dbornhorst/JacquardMachine-PCB/hardware/Jacquard_Machine_Brain/Jacquard_Machine_Brain.png

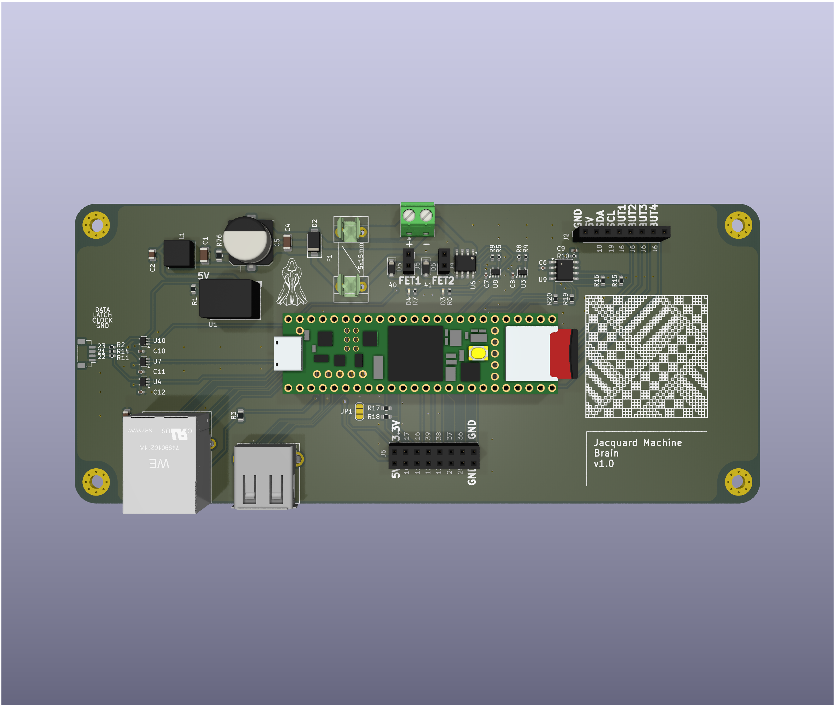
hardware/Jacquard_Machine_Brain/Jacquard_Machine_Brain.png
