dbornhorst/JacquardMachine-PCB/hardware/Jacquard_Machine_Driver/Jacquard_Machine_Driver.png

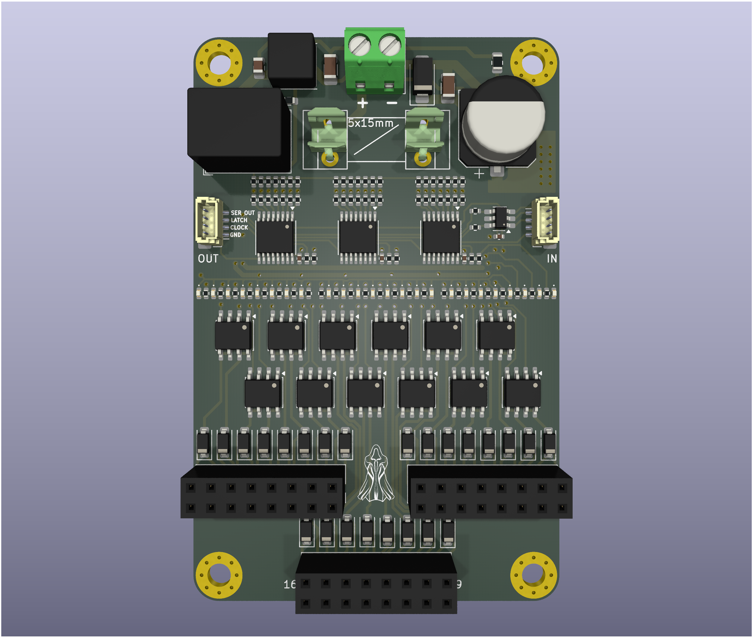
hardware/Jacquard_Machine_Driver/Jacquard_Machine_Driver.png
