dbornhorst/JacquardMachine-PCB/hardware/Jacquard_Machine_Driver/Jacquard_Machine_Driver.step

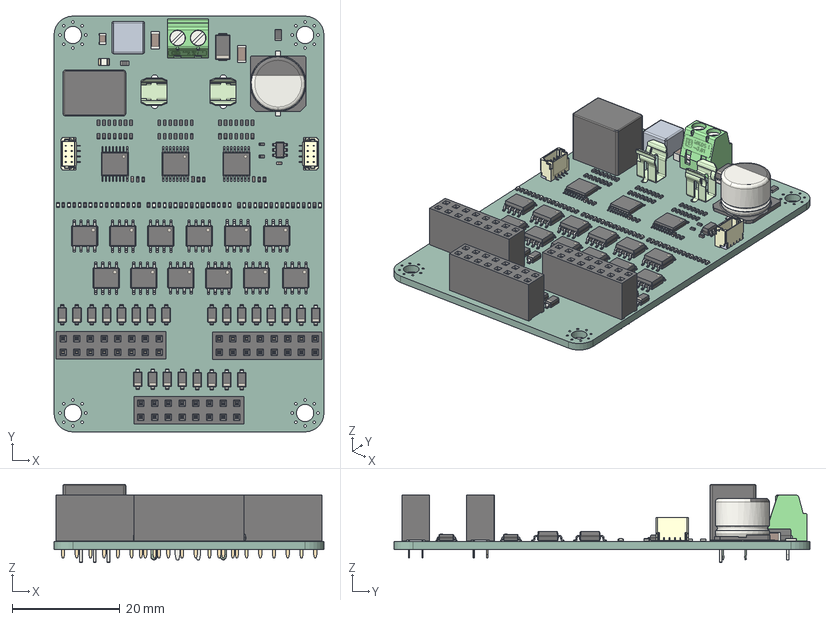
[picture p3: CAD file, 2026-09-17]
hardware/Jacquard_Machine_Driver/Jacquard_Machine_Driver.step
50.0 x 77.0 x 14.5 mm
R_0402_1005Metric x 74
LED_0805_2012Metric
LED_0402_1005Metric x 24
SOT-23-6
JST-SH_4POS_VERT_BM04B-SRSS-TB_LF x 2
SOIC-8_3.9x4.9mm_P1.27mm x 12
D_SOD-123 x 24
PinSocket_2x08_P2.54mm_Vertical x 3
Jacquard_Machine_Driver 1.19.1
C_0402_1005Metric x 4
Converter_DCDC_RECOM_R-78E-0.5_THT
TSSOP-16_4.4x5mm_P0.65mm x 3
C_0805_2012Metric
C_1206_3216Metric x 2
2AG_Fuse_Clip x 2
R_0603_1608Metric
CP_Elec_10x7.9
R_0805_2012Metric
D_SMA
Jacquard_Machine_Driver_PCB
