dbornhorst/JacquardMachine-PCB/hardware/Jacquard_Machine_Brain/documentation/Jacquard_Machine_Brain-v1.0-FAB.pdf

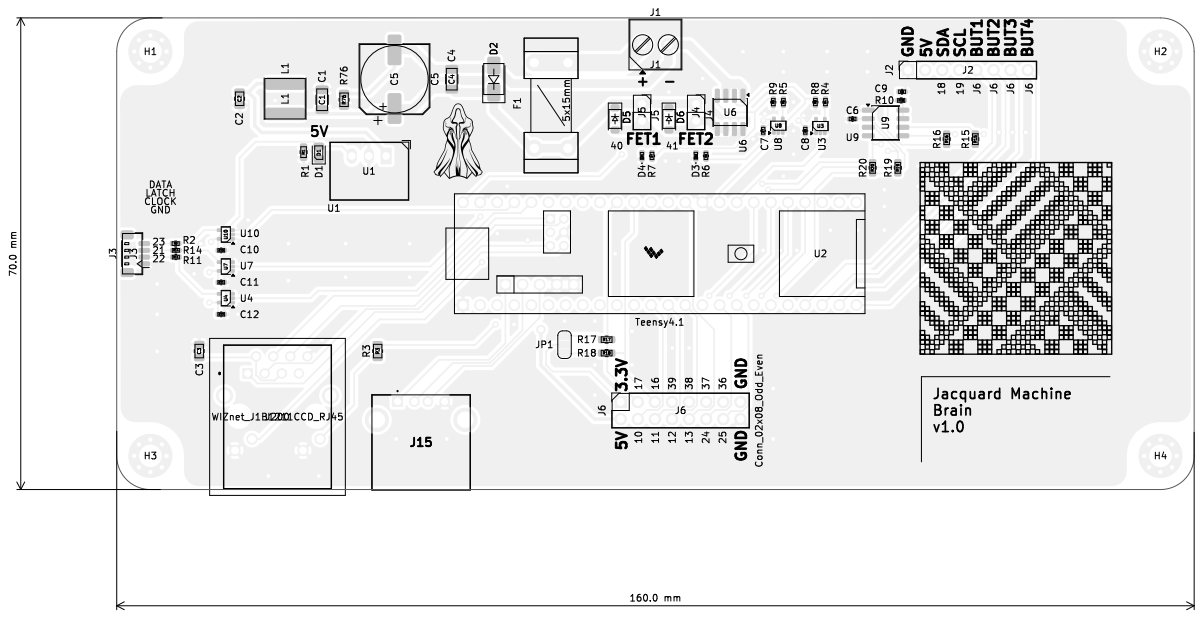
[picture p4: page 1]

File: Jacquard_Machine_Brain.kicad_pcb Sheet: Black And White TOP Daniel Bornhorst dbornhorst@gmail.com

Id: /1 Title: Jacquard Machine Brain

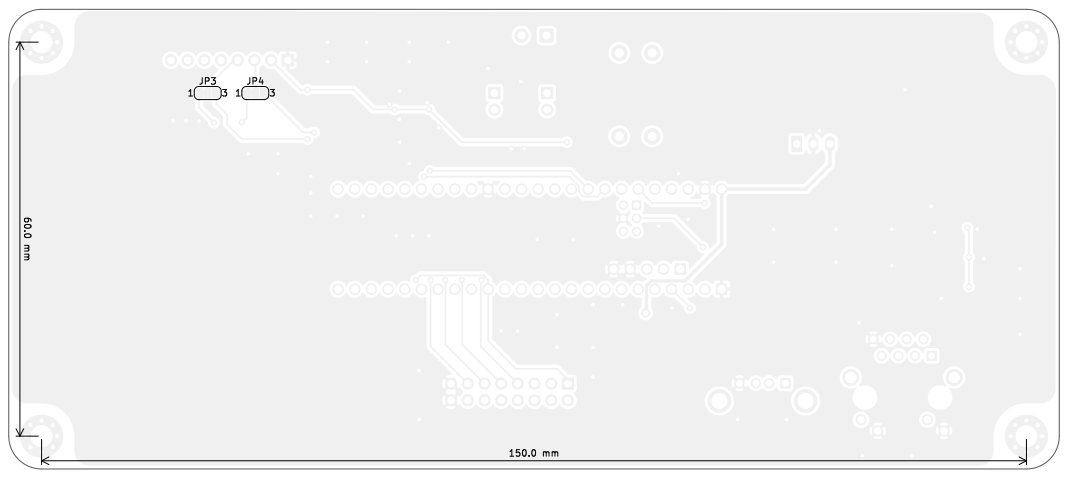
[picture p5: page 2]
D Date: 2026-09-15 KiCad; E.D.A. 9.0.6 Size: A4; Rev: v1.0; File: Jacquard_Machine_Brain.kicad_pcb Sheet: Black; And; White; BOT Daniel; Bornhorst dbornhorst@gmail.com; Board2Pdf:; Black; BOT -; Page 2/2

Id: /1 Title: Jacquard Machine Brain
