dbornhorst/JacquardMachine-PCB/hardware/Jacquard_Machine_Driver/documentation/Jacquard_Machine_Driver-v1.0-FAB.pdf

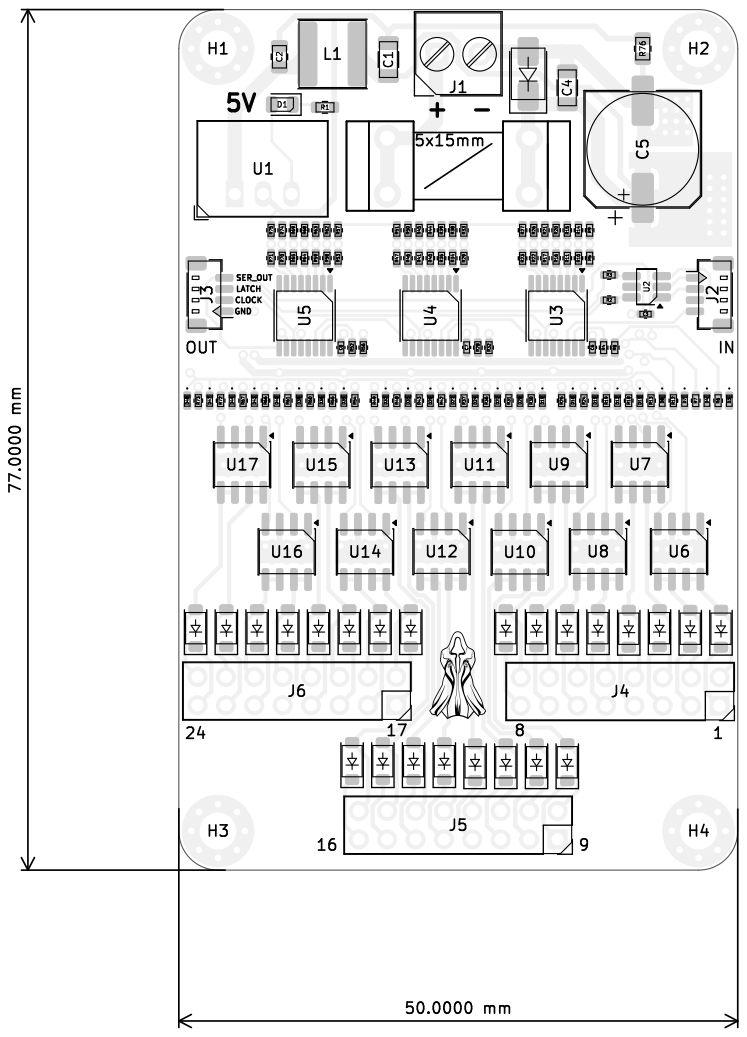
[picture p6: page 1]

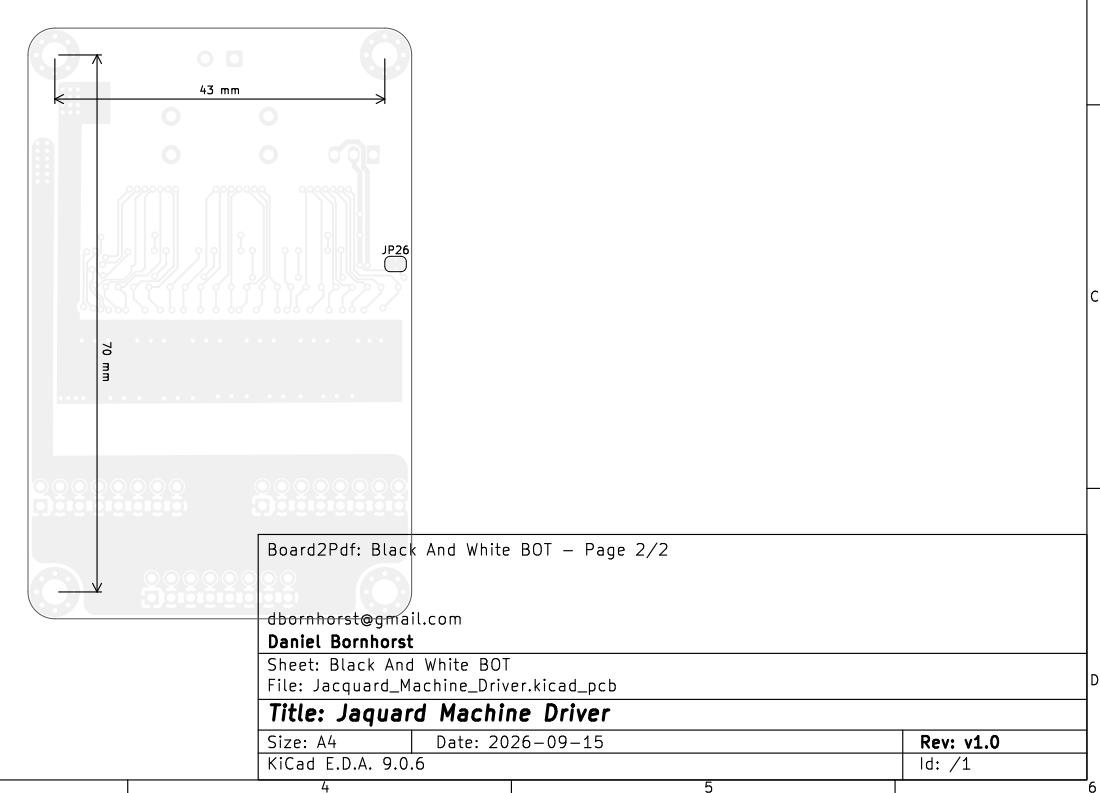
[picture p7: page 2]
D Date: 2026-09-15 KiCad; E.D.A. 9.0.6 Size: A4; Rev: v1.0; Id: /1 Title: Jaquard Machine Driver File: Jacquard_Machine_Driver.kicad_pcb Sheet: Black; And; White; BOT Daniel; Bornhorst dbornhorst@gmail.com; Board2Pdf:; Black; BOT -; Page 2/2
