dbornhorst/JacquardMachine-PCB/hardware/Jacquard_Machine_Brain/documentation/Jacquard_Machine_Brain-v1.0-SCHEM.pdf

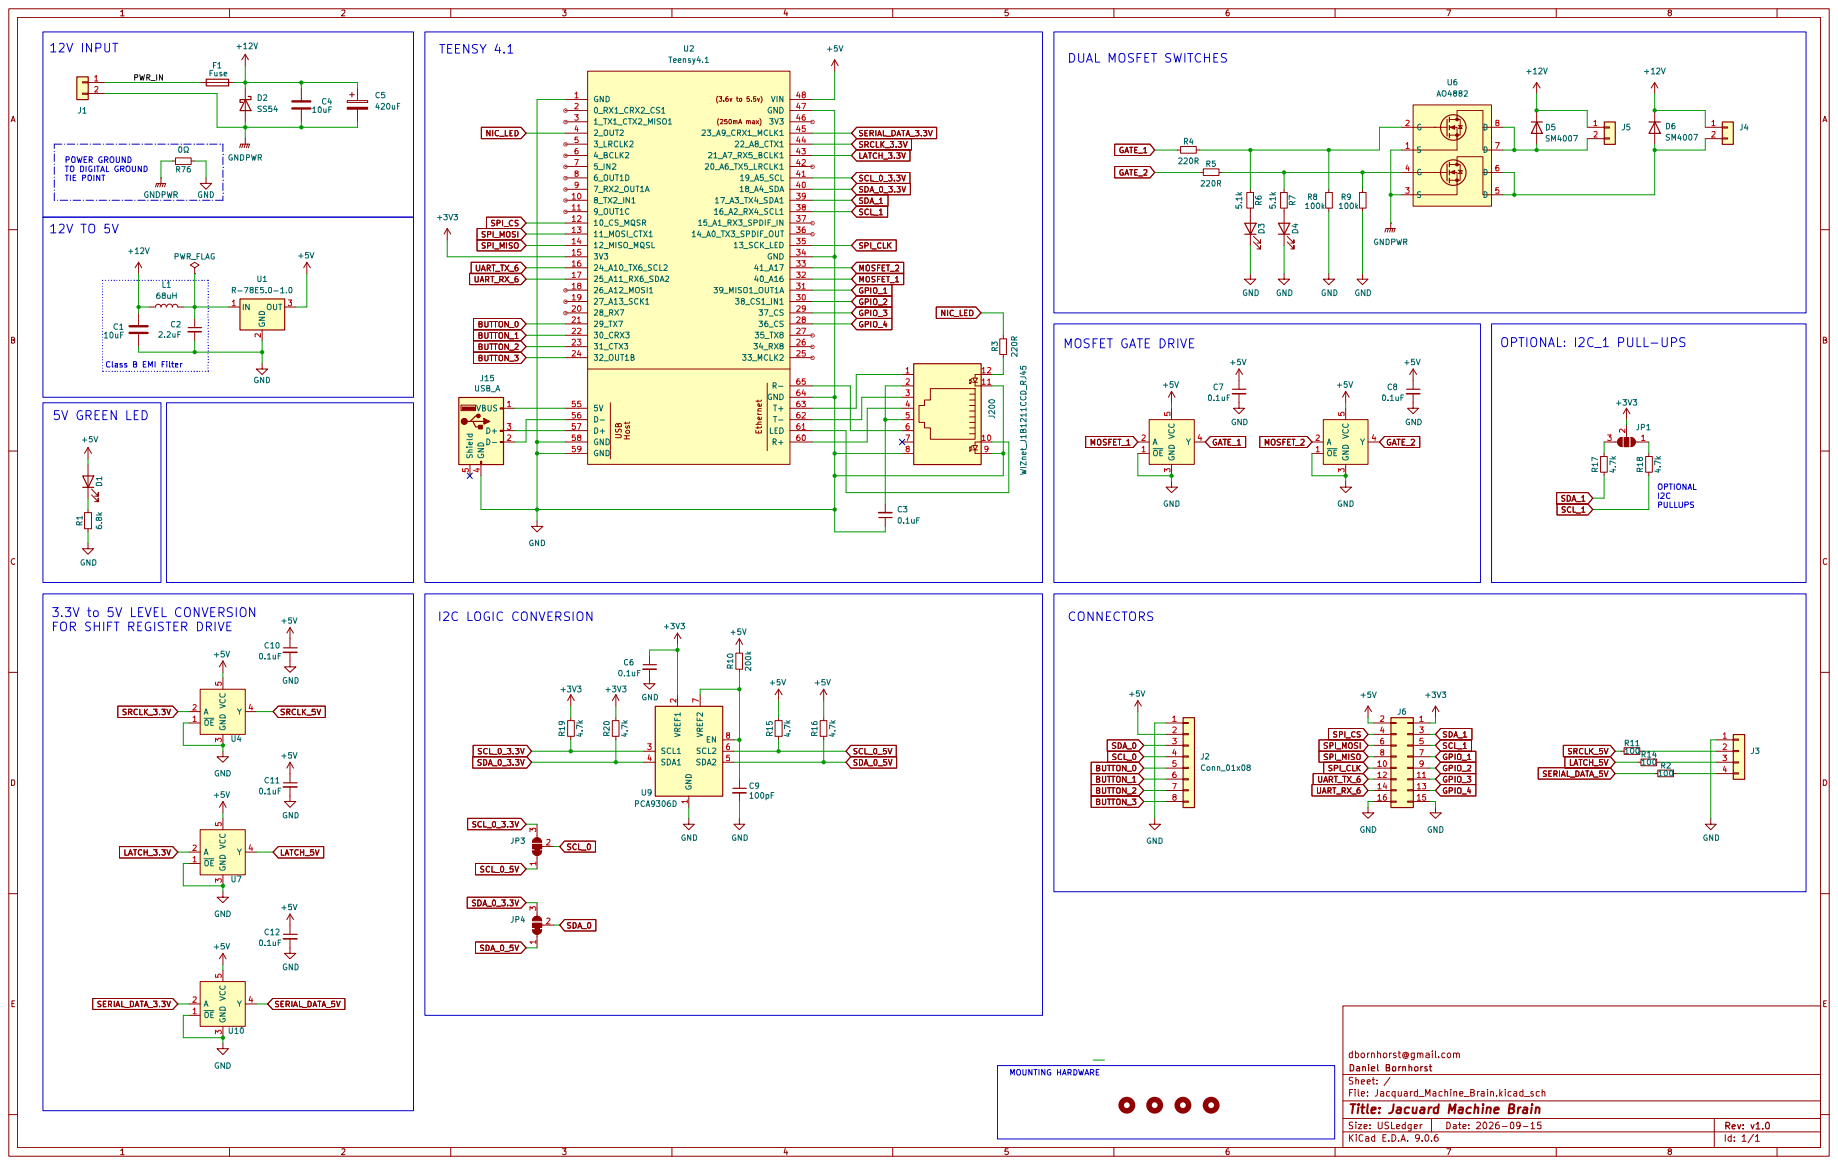
[picture p8: page 1]
