dbornhorst/JacquardMachine-PCB/hardware/Jacquard_Machine_Driver/documentation/Jacquard_Machine_Driver-v1.0-SCHEM.pdf

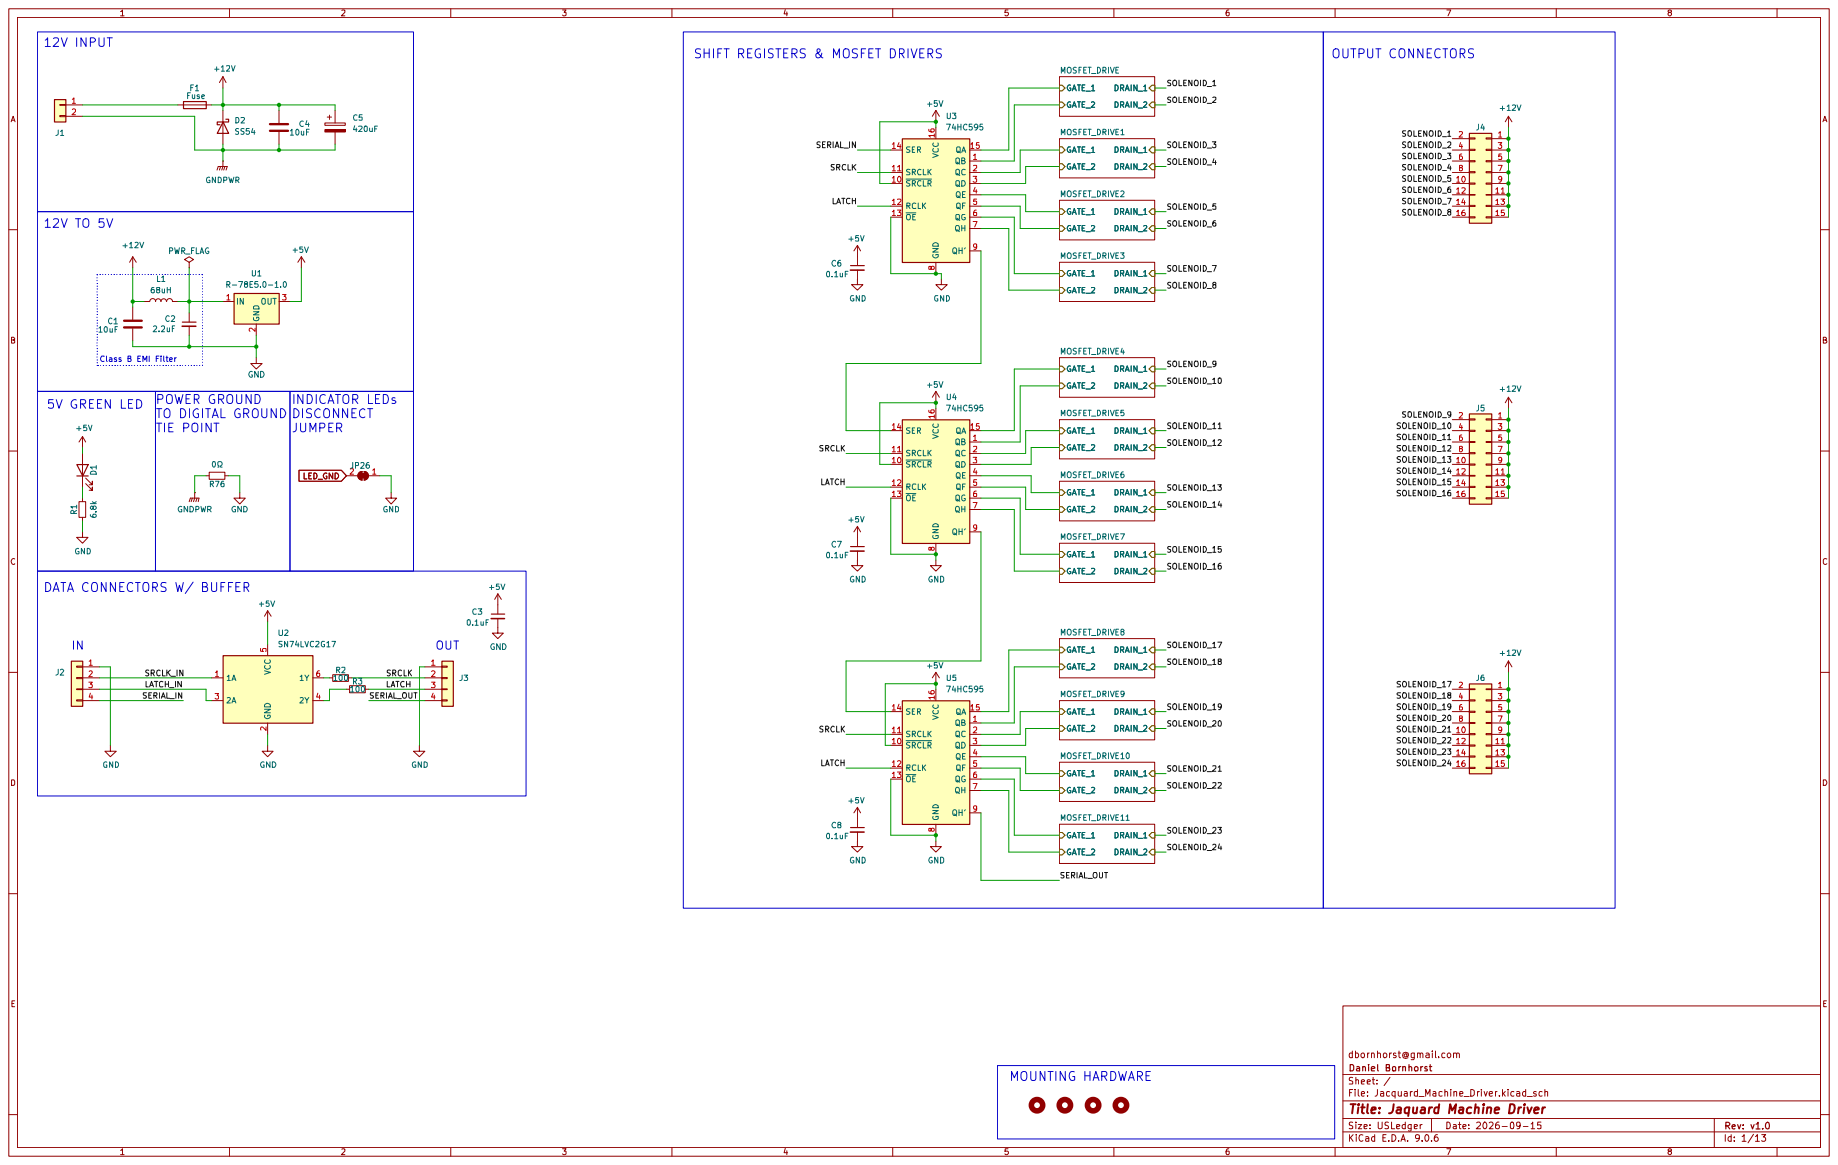
[picture p9: page 1]

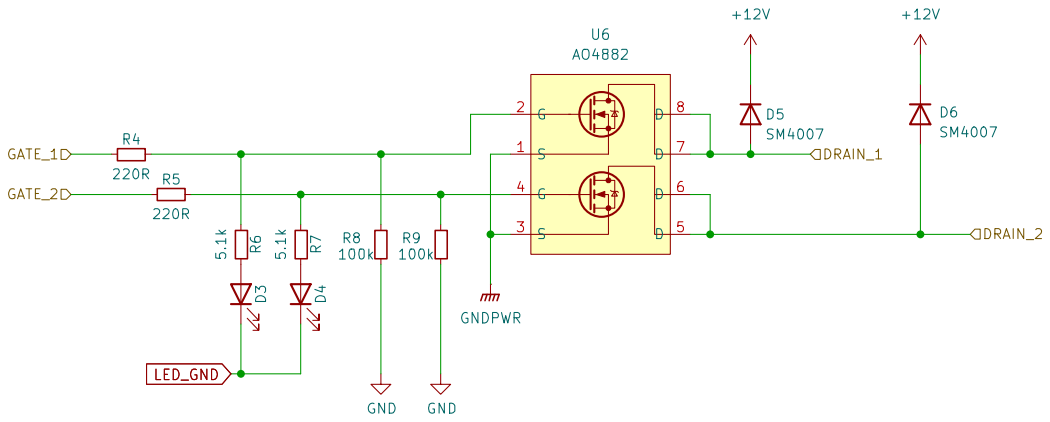
[picture p10: page 2]
