dbornhorst/JacquardMachine-PCB/hardware/Jacquard_Machine_Brain/Jacquard_Machine_Brain.kicad_pcb

## KiCad design hardware/Jacquard_Machine_Brain/Jacquard_Machine_Brain.kicad_pcb (2026-09-17)

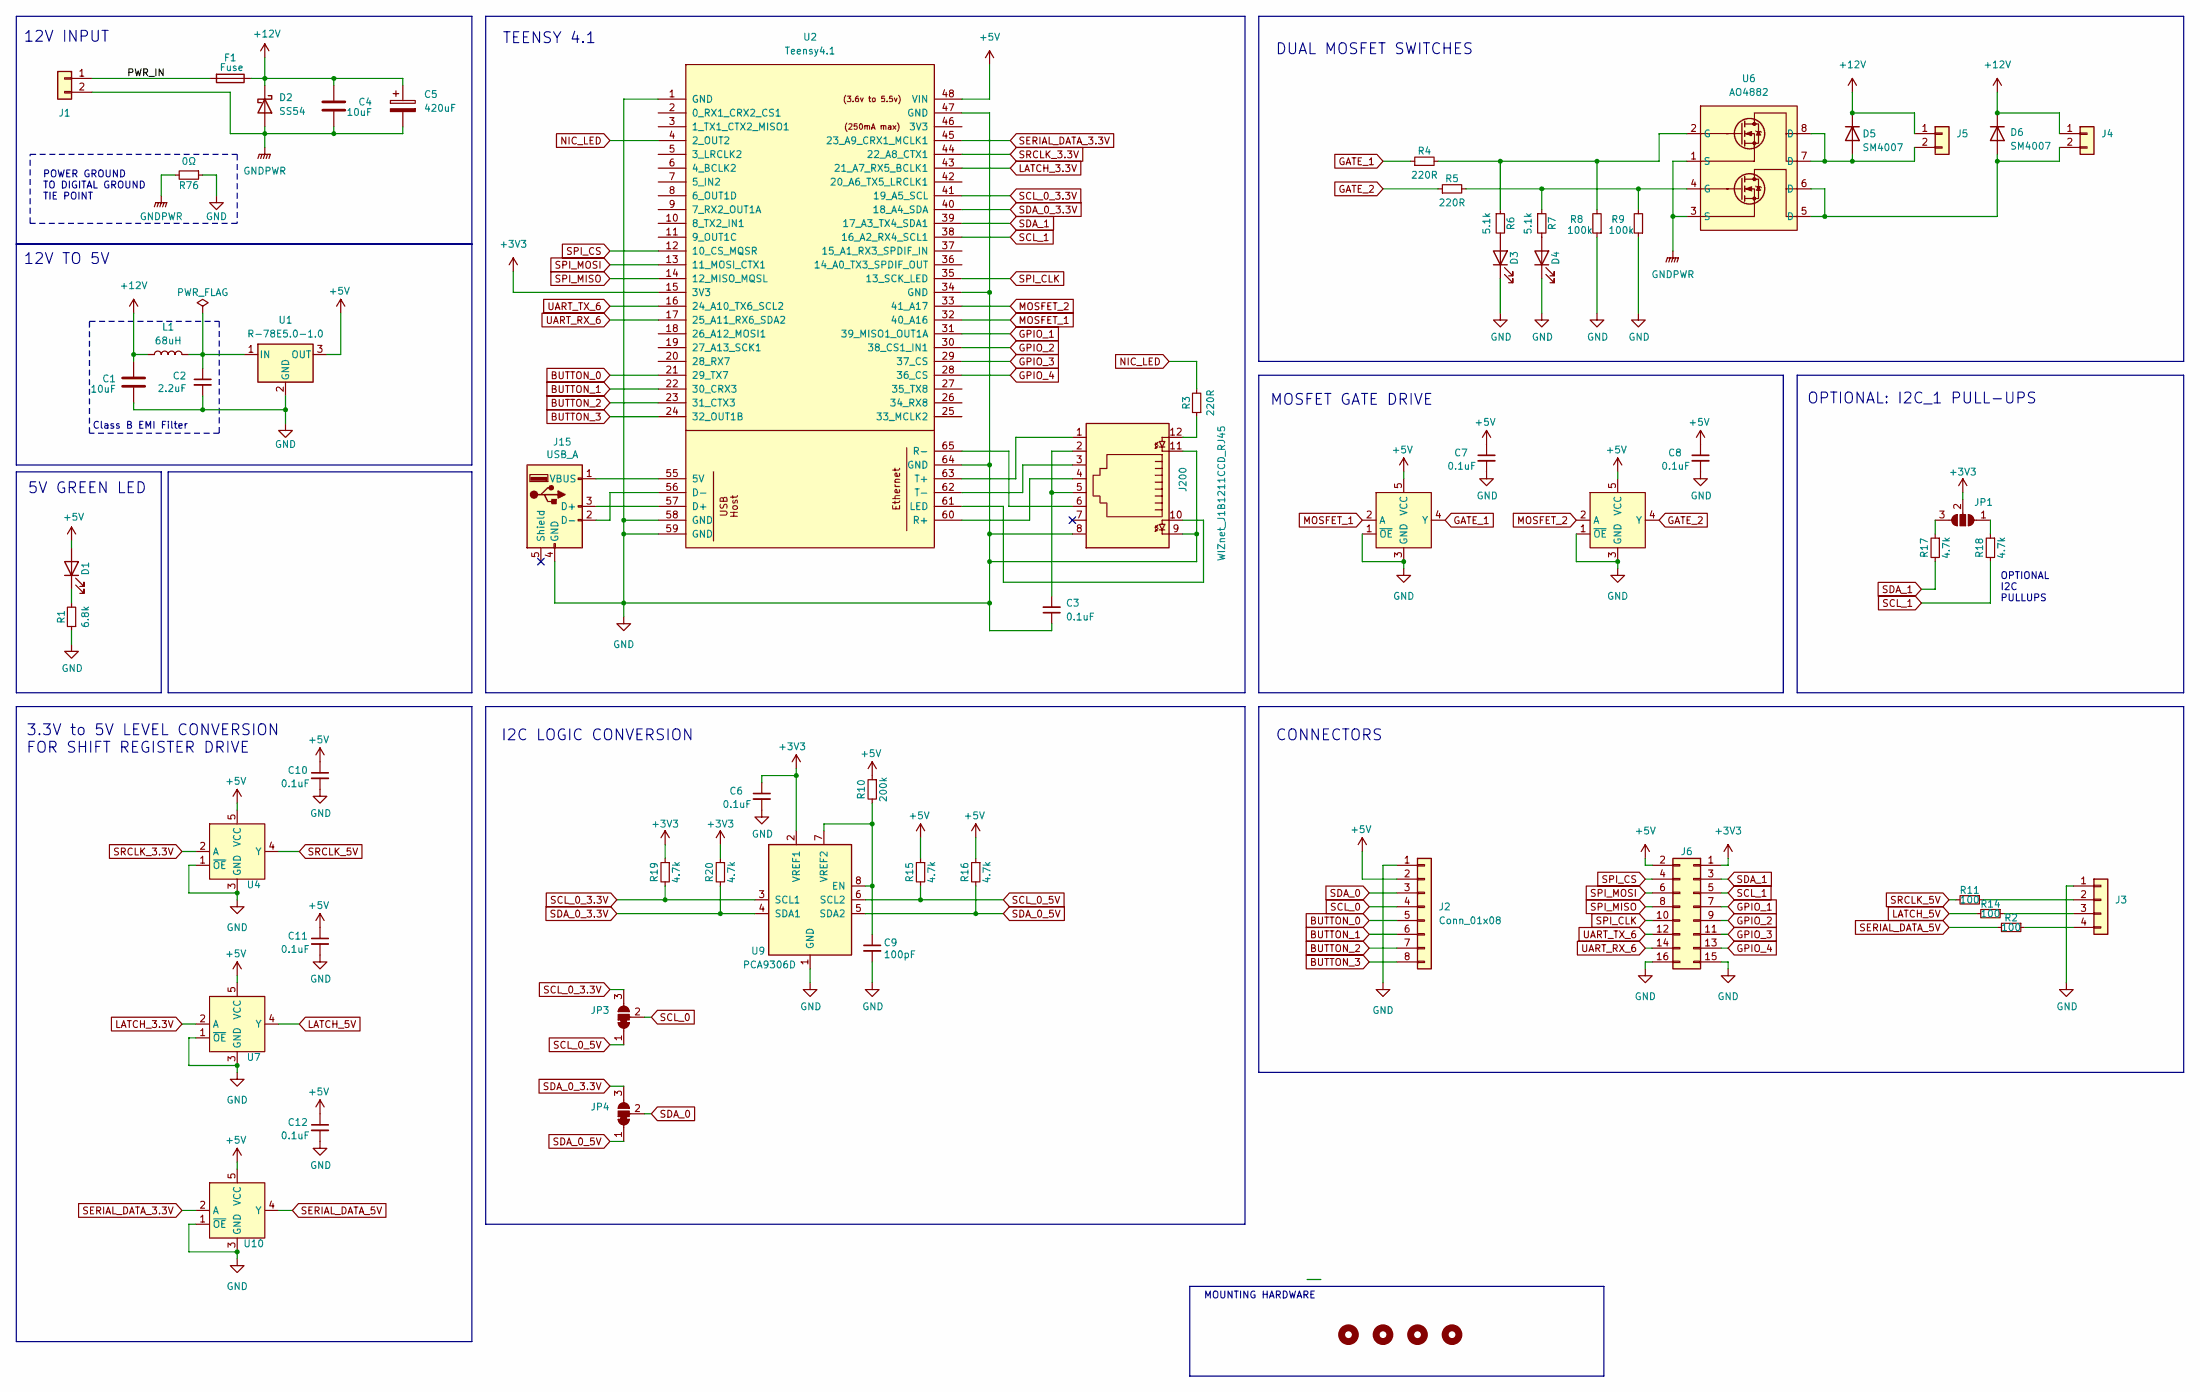
[picture p11: schematic Jacquard_Machine_Brain.kicad_sch, Jacuard Machine Brain]

Parts:
C1, C4: 10uF; C_1206_3216Metric; LCSC C13585
C2: 2.2uF; C_0805_2012Metric; LCSC C377773
C3: 0.1uF; C_0805_2012Metric; LCSC C49678
C5: 420uF; CP_Elec_10x7.9; LCSC C3350
C6, C7, C8, C10, C11, C12: 0.1uF; C_0402_1005Metric; LCSC C1525
C9: 100pF; C_0402_1005Metric; LCSC C1546
D1: GREEN LED; LED_0805_2012Metric; LCSC C2297
D2: SS54; D_SMA; LCSC C22452
D3, D4: RED LED; LED_0402_1005Metric; LCSC C397045
D5, D6: SM4007; D_SOD-123; LCSC C64898
F1: Fuse; Fuseholder_2AG_5x15mm_Littelfuse_01110501Z; LCSC C151075
H1, H2, H3, H4: MountingHole; MountingHole_3.2mm_M3_Pad_Via
J1: Terminal Block; TerminalBlock_Phoenix_MKDS-1-2-3.81_1x02_P3.81mm_Horizontal; LCSC C89123
J2: Conn_01x08; PinSocket_1x08_P2.54mm_Vertical; LCSC C42431840
J3: JST-SH 01x04; JST_SH_BM04B-SRSS-TB_1x04-1MP_P1.00mm_Vertical; LCSC C160390
J4, J5: Conn_01x02; PinSocket_1x02_P2.54mm_Vertical; LCSC C7499322
J6: Conn_02x08_Odd_Even; PinSocket_2x08_P2.54mm_Vertical; LCSC C30734
J15: USB_A; SAMTEC_USB-A-S-S-W-TH; LCSC C5815125
J200: WIZnet_J1B1211CCD_RJ45; Digikey P/N 1278-1052-ND
JP1: SolderJumper_3_Bridged123; SolderJumper-3_P1.3mm_Open_RoundedPad1.0x1.5mm
JP3, JP4: SolderJumper_3_Bridged12; SolderJumper-3_P1.3mm_Bridged12_RoundedPad1.0x1.5mm_NumberL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
L1: 68uH; L_Sunlord_SWPA6045S; LCSC C53663
R1: 6.8k; R_0603_1608Metric; LCSC C23212
R2, R11, R14: 100; R_0402_1005Metric; LCSC C25076
R3: 220R; R_0805_2012Metric; Digikey P/N 311-220CRCT-ND
R4, R5: 220R; R_0402_1005Metric; LCSC C25091
R6, R7: 5.1k; R_0402_1005Metric; LCSC C25905
R8, R9: 100k; R_0402_1005Metric; LCSC C25741
R10: 200k; R_0402_1005Metric; LCSC C25764
R15, R16, R17, R18, R19, R20: 4.7k; R_0603_1608Metric; LCSC C23162
R76: 0Ω; R_0805_2012Metric; LCSC C17477
U1: R-78E5.0-1.0; Converter_DCDC_RECOM_R-78E-0.5_THT; LCSC C22371890
U2: Teensy4.1; Teensy41_ethernet_usb; LCSC C41376163
U3, U4, U7, U8, U10: 74AHCT1G125; SOT-353_SC-70-5; LCSC C151417
U6: AO4882; SOIC-8_3.9x4.9mm_P1.27mm; LCSC C477943
U9: PCA9306D; SO-8_3.9x4.9mm_P1.27mm; LCSC C2677369

Connections:
+3V3: C6.1, J6.1, JP1.2 (C), R19.1, R20.1, U2.15 (3V3), U9.2 (VREF1)
+5V: C7.1, C8.1, C10.1, C11.1, C12.1, D1.2 (A), J2.2, J6.2, R10.1, R15.1, R16.1, U1.3 (OUT), U2.48 (VIN), U3.5 (VCC), U4.5 (VCC), U7.5 (VCC), U8.5 (VCC), U10.5 (VCC)
+12V: C1.1, C4.1, C5.1, D2.1 (K), D5.1 (K), D6.1 (K), F1.1, J4.1, J5.1, L1.1
/PWR_IN: F1.2, J1.1
BUTTON_0: J2.5, U2.21 (29_TX7)
BUTTON_1: J2.6, U2.22 (30_CRX3)
BUTTON_2: J2.7, U2.23 (31_CTX3)
BUTTON_3: J2.8, U2.24 (32_OUT1B)
GATE_1: R4.1, U3.4 (Y)
GATE_2: R5.1, U8.4 (Y)
GND: C1.2, C2.2, C3.1, C6.2, C7.2, C8.2, C9.2, C10.2, C11.2, C12.2, D3.1 (K), D4.1 (K), J2.1, J3.1, J6.15, J6.16, J15.4 (GND), J200.8, J200.9, J200.11, R1.1, R8.1, R9.1, R76.1, U1.2 (GND), U2.1 (GND), U2.34 (GND), U2.47 (GND), U2.58 (GND), U2.59 (GND), U2.64 (GND), U3.1 (~OE), U3.3 (GND), U4.1 (~OE), U4.3 (GND), U7.1 (~OE), U7.3 (GND), U8.1 (~OE), U8.3 (GND), U9.1 (GND), U10.1 (~OE), U10.3 (GND)
GNDPWR: C4.2, C5.2, D2.2 (A), J1.2, R76.2, U6.1 (S), U6.3 (S)
GPIO_1: J6.7, U2.31 (39_MISO1_OUT1A)
GPIO_2: J6.9, U2.30 (38_CS1_IN1)
GPIO_3: J6.11, U2.29 (37_CS)
GPIO_4: J6.13, U2.28 (36_CS)
LATCH_3.3V: U2.43 (21_A7_RX5_BCLK1), U7.2 (A)
LATCH_5V: R14.2, U7.4 (Y)
MOSFET_1: U2.32 (40_A16), U3.2 (A)
MOSFET_2: U2.33 (41_A17), U8.2 (A)
NIC_LED: R3.2, U2.4 (2_OUT2)
unnamed: C3.2, J200.2, J200.5
unnamed: D1.1 (K), R1.2
unnamed: D3.2 (A), R6.2
unnamed: D4.2 (A), R7.2
unnamed: D5.2 (A), J5.2, U6.7 (D), U6.8 (D)
unnamed: D6.2 (A), J4.2, U6.5 (D), U6.6 (D)
unnamed: J3.2, R11.1
unnamed: J3.3, R14.1
unnamed: J3.4, R2.1
unnamed: J15.3 (D+), U2.57 (D+)
unnamed: J15.2 (D-), U2.56 (D-)
unnamed: J15.1 (VBUS), U2.55 (5V)
unnamed: J200.12, R3.1
unnamed: JP1.1 (A), R18.1
unnamed: JP1.3 (B), R17.1
unnamed: R4.2, R6.1, R8.2, U6.2 (G)
unnamed: R5.2, R7.1, R9.2, U6.4 (G)
unnamed: C2.1, L1.2, U1.1 (IN)
unnamed: J200.10, U2.61 (LED)
unnamed: J200.4, U2.60 (R+)
unnamed: J200.6, U2.65 (R-)
unnamed: J200.1, U2.63 (T+)
unnamed: J200.3, U2.62 (T-)
unnamed: C9.1, R10.2, U9.7 (VREF2), U9.8 (EN)
SCL_0: J2.4, JP3.2 (C)
SCL_0_3.3V: JP3.3 (B), R19.2, U2.41 (19_A5_SCL), U9.3 (SCL1)
SCL_0_5V: JP3.1 (A), R15.2, U9.6 (SCL2)
SCL_1: J6.5, R18.2, U2.38 (16_A2_RX4_SCL1)
SDA_0: J2.3, JP4.2 (C)
SDA_0_3.3V: JP4.3 (B), R20.2, U2.40 (18_A4_SDA), U9.4 (SDA1)
SDA_0_5V: JP4.1 (A), R16.2, U9.5 (SDA2)
SDA_1: J6.3, R17.2, U2.39 (17_A3_TX4_SDA1)
SERIAL_DATA_3.3V: U2.45 (23_A9_CRX1_MCLK1), U10.2 (A)
SERIAL_DATA_5V: R2.2, U10.4 (Y)
SPI_CLK: J6.10, U2.35 (13_SCK_LED)
SPI_CS: J6.4, U2.12 (10_CS_MQSR)
SPI_MISO: J6.8, U2.14 (12_MISO_MQSL)
SPI_MOSI: J6.6, U2.13 (11_MOSI_CTX1)
SRCLK_3.3V: U2.44 (22_A8_CTX1), U4.2 (A)
SRCLK_5V: R11.2, U4.4 (Y)
UART_RX_6: J6.14, U2.17 (25_A11_RX6_SDA2)
UART_TX_6: J6.12, U2.16 (24_A10_TX6_SCL2)

Notes on the sheet:
OPTIONAL: I2C_1 PULL-UPS
5V GREEN LED
3.3V to 5V LEVEL CONVERSION FOR SHIFT REGISTER DRIVE
I2C LOGIC CONVERSION
TEENSY 4.1
MOSFET GATE DRIVE
DUAL MOSFET SWITCHES
MOUNTING HARDWARE
OPTIONAL I2C PULLUPS
12V INPUT
12V TO 5V
Class B EMI Filter
POWER GROUND TO DIGITAL GROUND TIE POINT
CONNECTORS

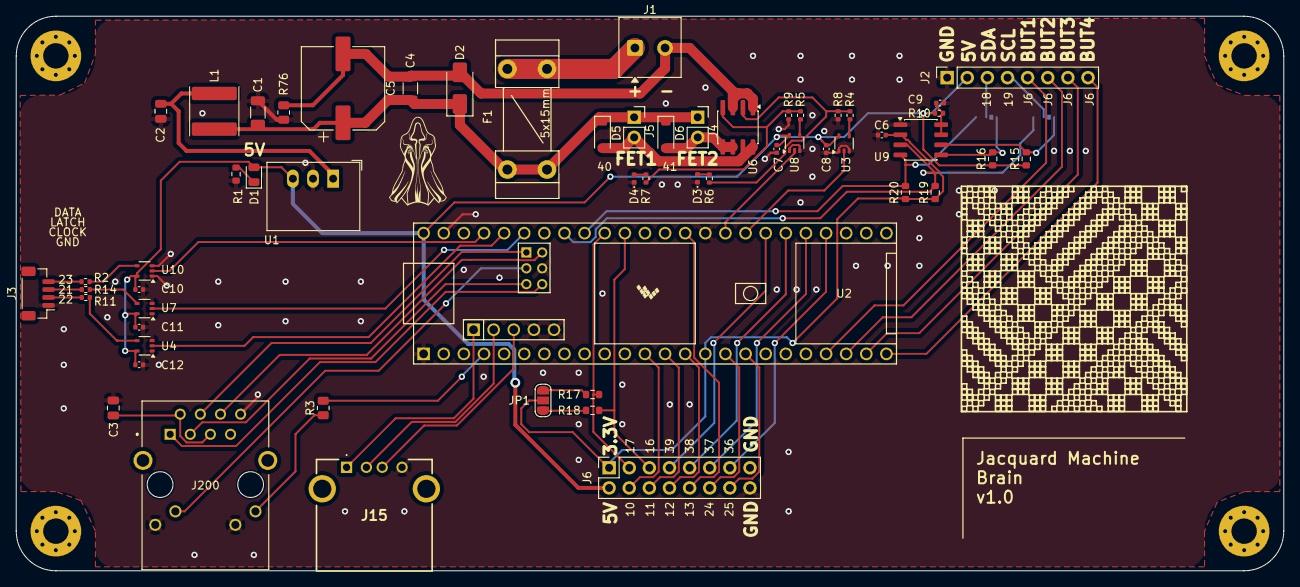
[picture p12: board Jacquard_Machine_Brain.kicad_pcb from above]

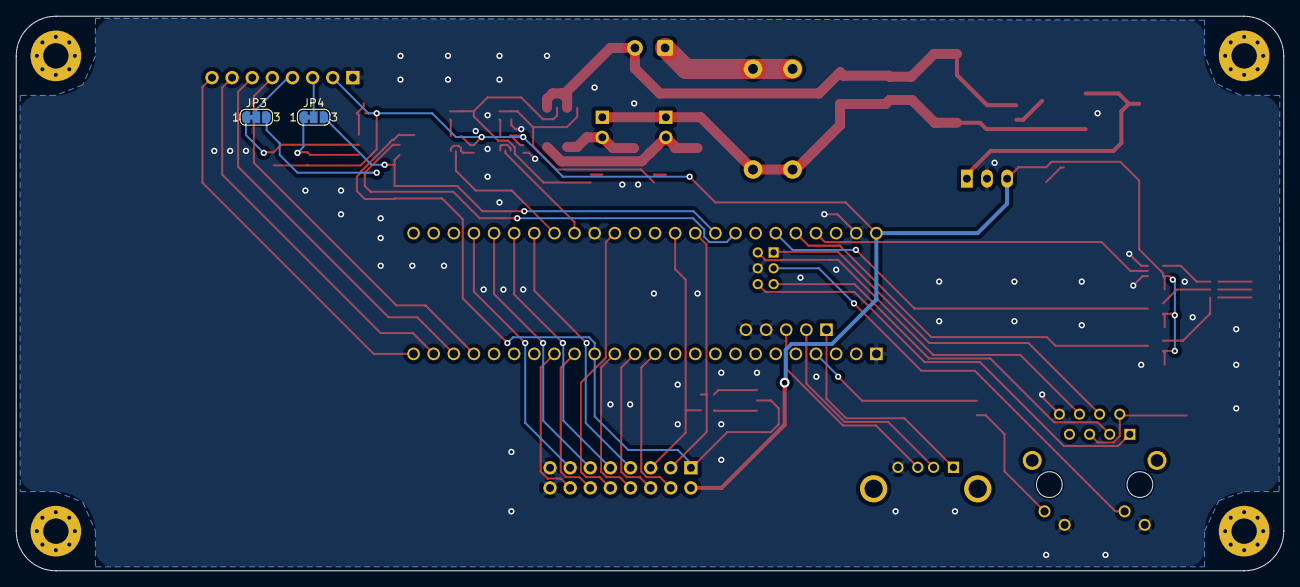
[picture p13: board Jacquard_Machine_Brain.kicad_pcb from below]

Board: 2 copper layers, 160.0 x 70.0 mm, 63 parts (2 on the bottom side), 63 nets.
