dbornhorst/JacquardMachine-PCB/hardware/Jacquard_Machine_Driver/Jacquard_Machine_Driver.kicad_pcb

## KiCad design hardware/Jacquard_Machine_Driver/Jacquard_Machine_Driver.kicad_pcb (2026-09-17)

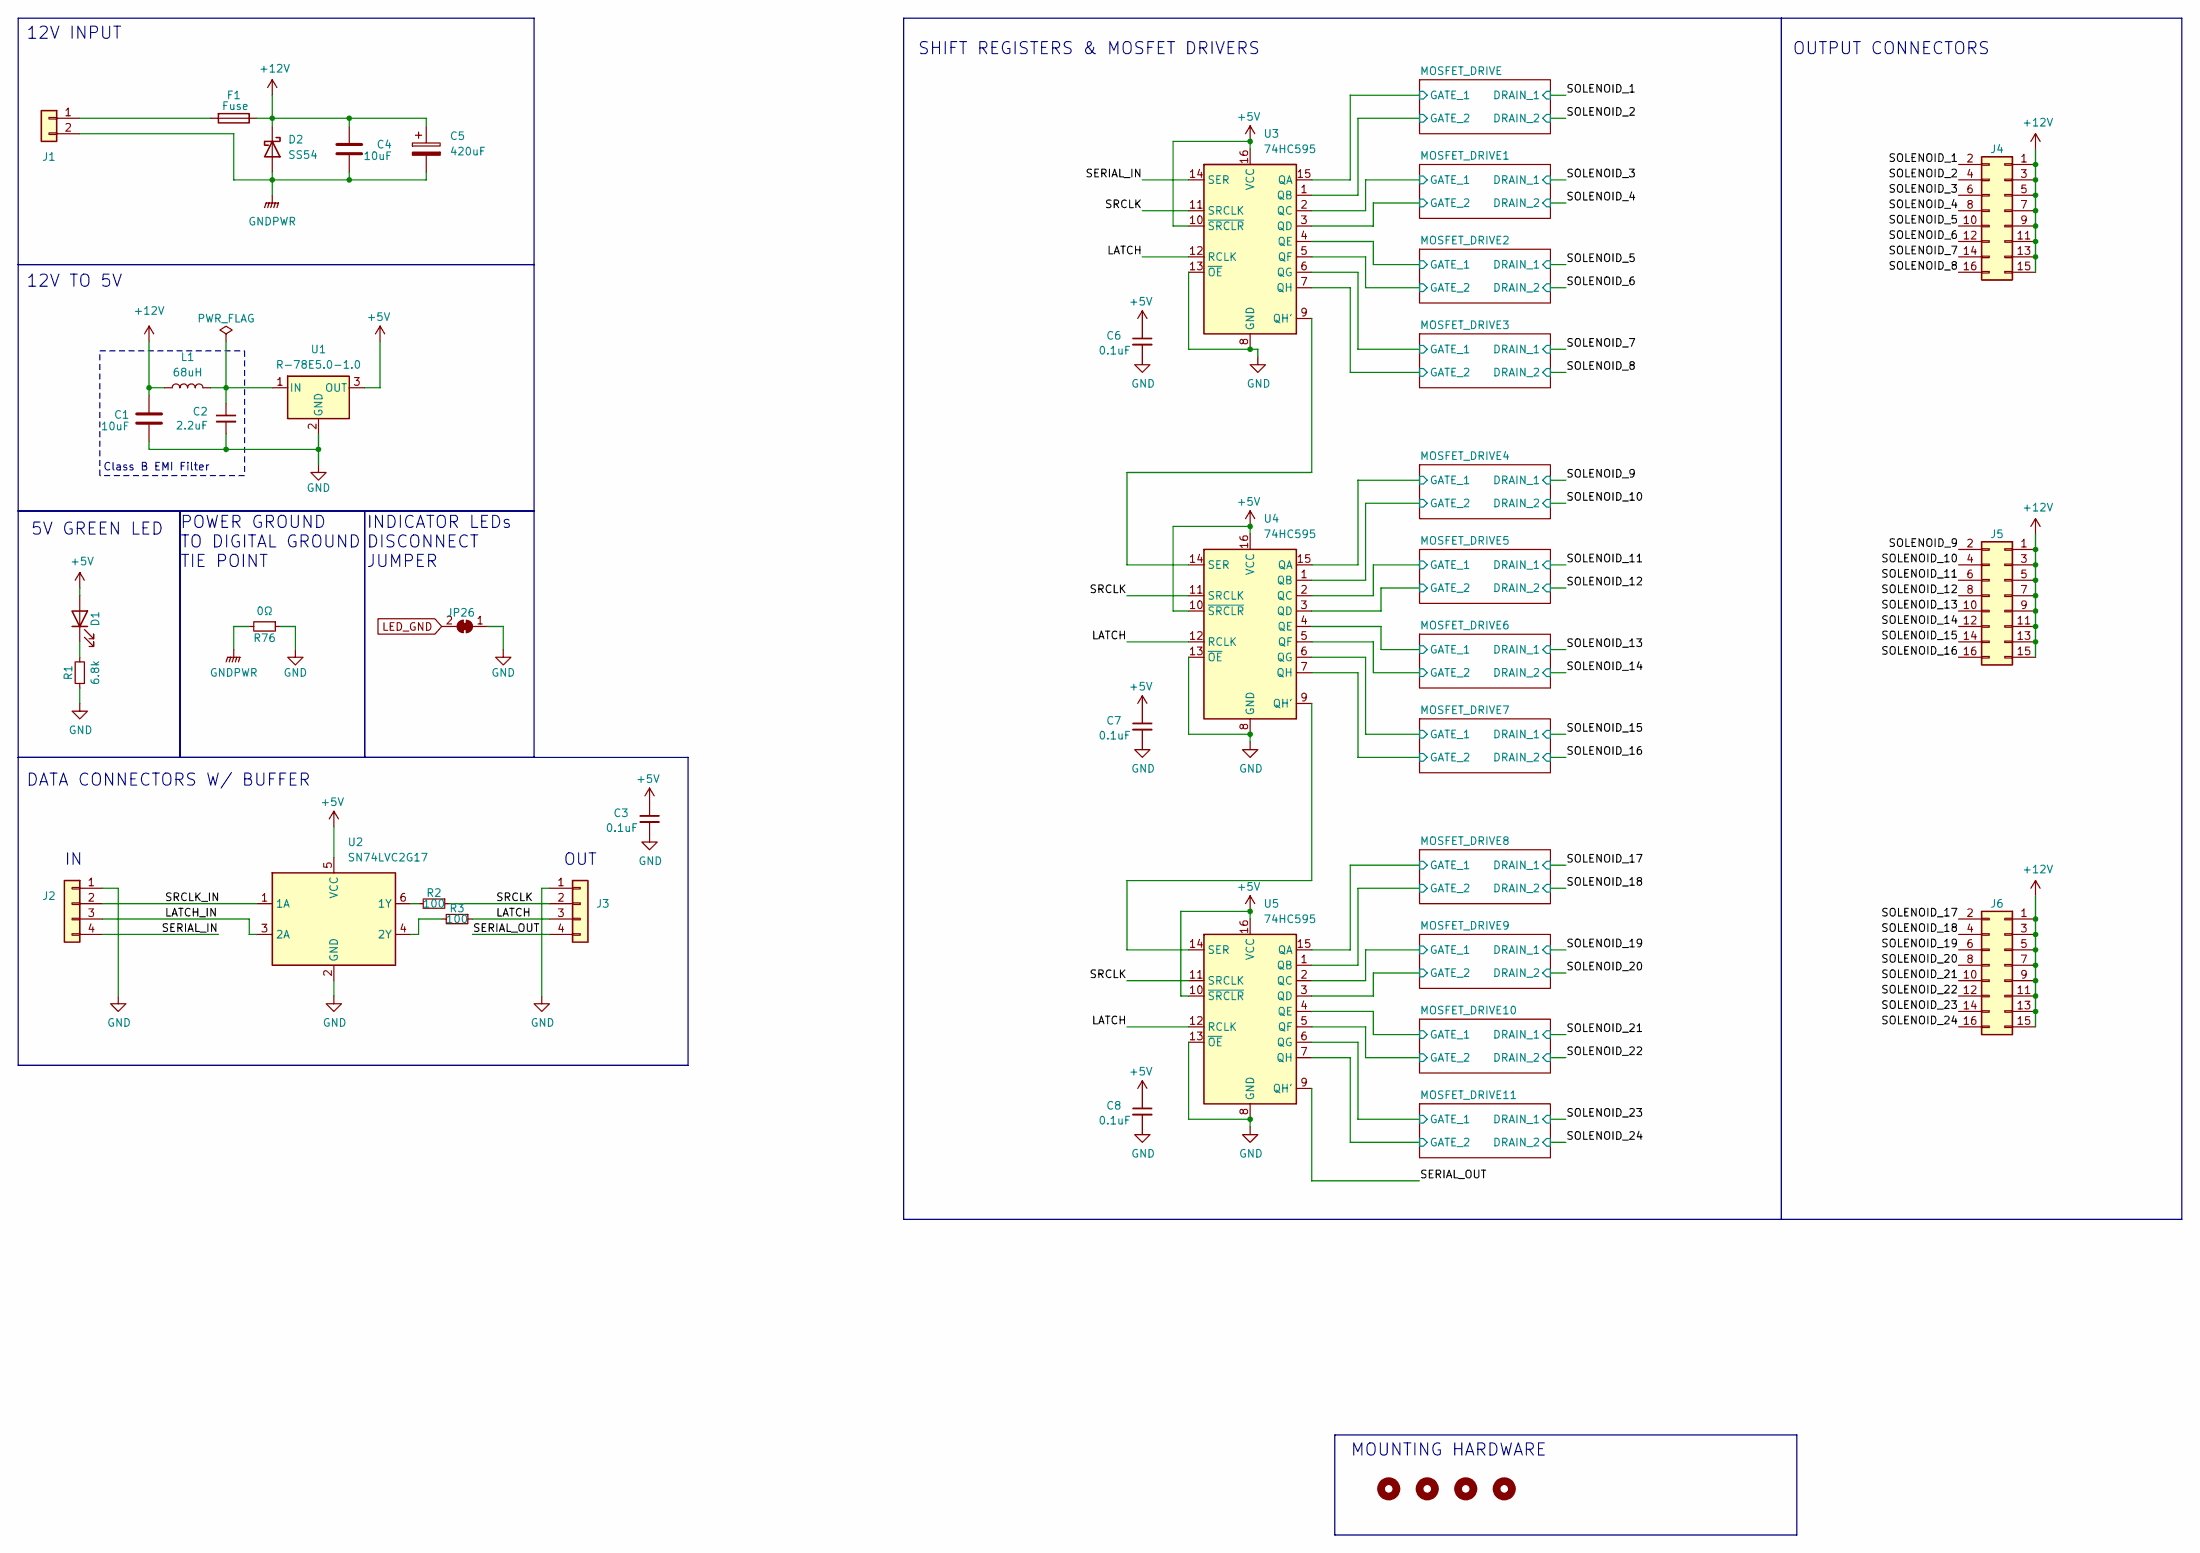
[picture p14: schematic Jacquard_Machine_Driver.kicad_sch, Jaquard Machine Driver]

Parts:
C1, C4: 10uF; C_1206_3216Metric; LCSC C13585
C2: 2.2uF; C_0805_2012Metric; LCSC C377773
C3, C6, C7, C8: 0.1uF; C_0402_1005Metric; LCSC C1525
C5: 420uF; CP_Elec_10x7.9; LCSC C3350
D1: GREEN LED; LED_0805_2012Metric; LCSC C2297
D2: SS54; D_SMA; LCSC C22452
F1: Fuse; Fuseholder_2AG_5x15mm_Littelfuse_01110501Z; LCSC C151075
H1, H2, H3, H4: MountingHole; MountingHole_3.2mm_M3_Pad_Via
J1: Terminal Block; TerminalBlock_Phoenix_MKDS-1-2-3.81_1x02_P3.81mm_Horizontal; LCSC C89123
J2, J3: JST-SH 01x04; JST_SH_BM04B-SRSS-TB_1x04-1MP_P1.00mm_Vertical; LCSC C160390
J4, J5, J6: Conn_02x08_Odd_Even; PinSocket_2x08_P2.54mm_Vertical; LCSC C30734
JP26: SolderJumper_2_Bridged; SolderJumper-2_P1.3mm_Bridged_RoundedPad1.0x1.5mm
L1: 68uH; L_Sunlord_SWPA6045S; LCSC C53663
R1: 6.8k; R_0603_1608Metric; LCSC C23212
R2, R3: 100; R_0402_1005Metric; LCSC C25076
R76: 0Ω; R_0805_2012Metric; LCSC C17477
U1: R-78E5.0-1.0; Converter_DCDC_RECOM_R-78E-0.5_THT; LCSC C22371890
U2: SN74LVC2G17; SOT-23-6_Handsoldering; LCSC C10429
U3, U4, U5: 74HC595; TSSOP-16_4.4x5mm_P0.65mm; LCSC C273642

Connections:
+5V: C3.1, C6.1, C7.1, C8.1, D1.2 (A), U1.3 (OUT), U2.5 (VCC), U3.10 (~SRCLR), U3.16 (VCC), U4.10 (~SRCLR), U4.16 (VCC), U5.10 (~SRCLR), U5.16 (VCC)
+12V: C1.1, C4.1, C5.1, D2.1 (K), F1.1, J4.1, J4.3, J4.5, J4.7, J4.9, J4.11, J4.13, J4.15, J5.1, J5.3, J5.5, J5.7, J5.9, J5.11, J5.13, J5.15, J6.1, J6.3, J6.5, J6.7, J6.9, J6.11, J6.13, J6.15, L1.1; also elsewhere on the board
/LATCH: J3.3, R3.1, U3.12 (RCLK), U4.12 (RCLK), U5.12 (RCLK)
/MOSFET_DRIVE1/GATE_1: U3.2 (QC); also elsewhere on the board
/MOSFET_DRIVE1/GATE_2: U3.3 (QD); also elsewhere on the board
/MOSFET_DRIVE2/GATE_1: U3.4 (QE); also elsewhere on the board
/MOSFET_DRIVE2/GATE_2: U3.5 (QF); also elsewhere on the board
/MOSFET_DRIVE3/GATE_1: U3.6 (QG); also elsewhere on the board
/MOSFET_DRIVE3/GATE_2: U3.7 (QH); also elsewhere on the board
/MOSFET_DRIVE4/GATE_1: U4.15 (QA); also elsewhere on the board
/MOSFET_DRIVE4/GATE_2: U4.1 (QB); also elsewhere on the board
/MOSFET_DRIVE5/GATE_1: U4.2 (QC); also elsewhere on the board
/MOSFET_DRIVE5/GATE_2: U4.3 (QD); also elsewhere on the board
/MOSFET_DRIVE6/GATE_1: U4.4 (QE); also elsewhere on the board
/MOSFET_DRIVE6/GATE_2: U4.5 (QF); also elsewhere on the board
/MOSFET_DRIVE7/GATE_1: U4.6 (QG); also elsewhere on the board
/MOSFET_DRIVE7/GATE_2: U4.7 (QH); also elsewhere on the board
/MOSFET_DRIVE8/GATE_1: U5.15 (QA); also elsewhere on the board
/MOSFET_DRIVE8/GATE_2: U5.1 (QB); also elsewhere on the board
/MOSFET_DRIVE9/GATE_1: U5.2 (QC); also elsewhere on the board
/MOSFET_DRIVE9/GATE_2: U5.3 (QD); also elsewhere on the board
/MOSFET_DRIVE10/GATE_1: U5.4 (QE); also elsewhere on the board
/MOSFET_DRIVE10/GATE_2: U5.5 (QF); also elsewhere on the board
/MOSFET_DRIVE11/GATE_1: U5.6 (QG); also elsewhere on the board
/MOSFET_DRIVE11/GATE_2: U5.7 (QH); also elsewhere on the board
/MOSFET_DRIVE/GATE_1: U3.15 (QA); also elsewhere on the board
/MOSFET_DRIVE/GATE_2: U3.1 (QB); also elsewhere on the board
/SERIAL_IN: J2.4, U3.14 (SER)
/SERIAL_OUT: J3.4, U5.9 (QH')
/SOLENOID_1: J4.2; also elsewhere on the board
/SOLENOID_2: J4.4; also elsewhere on the board
/SOLENOID_3: J4.6; also elsewhere on the board
/SOLENOID_4: J4.8; also elsewhere on the board
/SOLENOID_5: J4.10; also elsewhere on the board
/SOLENOID_6: J4.12; also elsewhere on the board
/SOLENOID_7: J4.14; also elsewhere on the board
/SOLENOID_8: J4.16; also elsewhere on the board
/SOLENOID_9: J5.2; also elsewhere on the board
/SOLENOID_10: J5.4; also elsewhere on the board
/SOLENOID_11: J5.6; also elsewhere on the board
/SOLENOID_12: J5.8; also elsewhere on the board
/SOLENOID_13: J5.10; also elsewhere on the board
/SOLENOID_14: J5.12; also elsewhere on the board
/SOLENOID_15: J5.14; also elsewhere on the board
/SOLENOID_16: J5.16; also elsewhere on the board
/SOLENOID_17: J6.2; also elsewhere on the board
/SOLENOID_18: J6.4; also elsewhere on the board
/SOLENOID_19: J6.6; also elsewhere on the board
/SOLENOID_20: J6.8; also elsewhere on the board
/SOLENOID_21: J6.10; also elsewhere on the board
/SOLENOID_22: J6.12; also elsewhere on the board
/SOLENOID_23: J6.14; also elsewhere on the board
/SOLENOID_24: J6.16; also elsewhere on the board
/SRCLK: J3.2, R2.1, U3.11 (SRCLK), U4.11 (SRCLK), U5.11 (SRCLK)
GND: C1.2, C2.2, C3.2, C6.2, C7.2, C8.2, J2.1, J3.1, JP26.1 (A), R1.1, R76.1, U1.2 (GND), U2.2 (GND), U3.8 (GND), U3.13 (~OE), U4.8 (GND), U4.13 (~OE), U5.8 (GND), U5.13 (~OE); also elsewhere on the board
GNDPWR: C4.2, C5.2, D2.2 (A), J1.2, R76.2; also elsewhere on the board
LED_GND: JP26.2 (B); also elsewhere on the board
unnamed: D1.1 (K), R1.2
unnamed: F1.2, J1.1
unnamed: J2.2, U2.1 (1A)
unnamed: J2.3, U2.3 (2A)
unnamed: C2.1, L1.2, U1.1 (IN)
unnamed: R2.2, U2.6 (1Y)
unnamed: R3.2, U2.4 (2Y)
unnamed: U3.9 (QH'), U4.14 (SER)
unnamed: U4.9 (QH'), U5.14 (SER)

Notes on the sheet:
POWER GROUND TO DIGITAL GROUND TIE POINT
DATA CONNECTORS W/ BUFFER
OUT
INDICATOR LEDs DISCONNECT JUMPER
5V GREEN LED
Class B EMI Filter
OUTPUT CONNECTORS
MOUNTING HARDWARE
12V TO 5V
SHIFT REGISTERS & MOSFET DRIVERS
12V INPUT

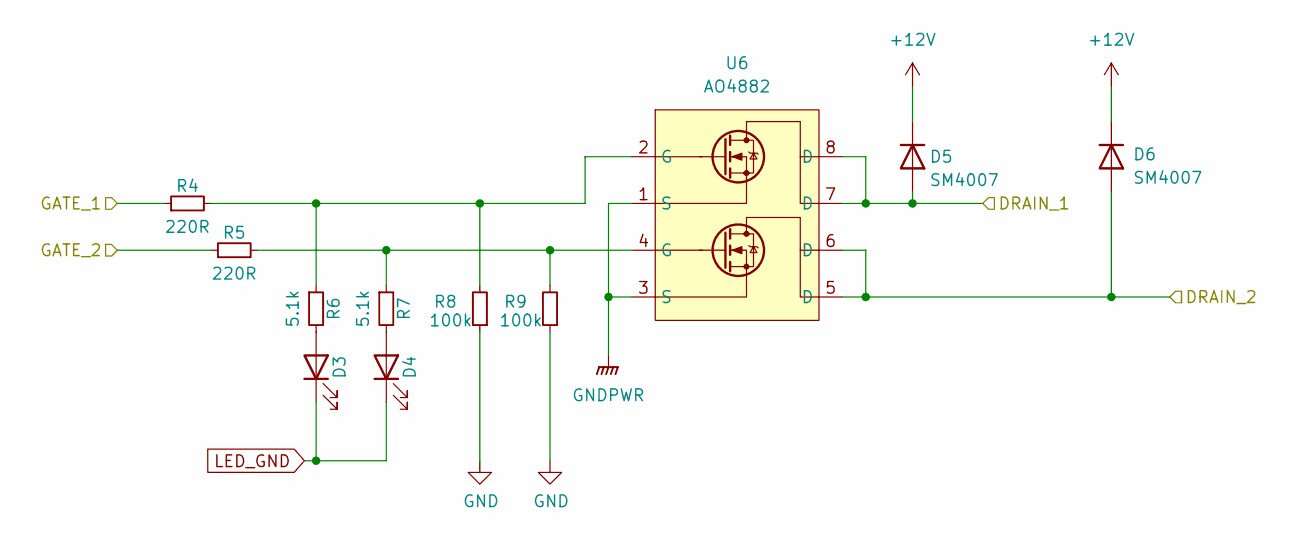
[picture p15: schematic mosfet_drive.kicad_sch]

Parts:
D3, D4: RED LED; LED_0402_1005Metric; LCSC C397045
D5, D6: SM4007; D_SOD-123; LCSC C64898
R4, R5: 220R; R_0402_1005Metric; LCSC C25091
R6, R7: 5.1k; R_0402_1005Metric; LCSC C25905
R8, R9: 100k; R_0402_1005Metric; LCSC C25741
U6: AO4882; SOIC-8_3.9x4.9mm_P1.27mm; LCSC C477943

Connections:
+12V: D5.1 (K), D6.1 (K); also elsewhere on the board
/MOSFET_DRIVE/GATE_1: R4.1; also elsewhere on the board
/MOSFET_DRIVE/GATE_2: R5.1; also elsewhere on the board
/SOLENOID_1: D5.2 (A), U6.7 (D), U6.8 (D); also elsewhere on the board
/SOLENOID_2: D6.2 (A), U6.5 (D), U6.6 (D); also elsewhere on the board
GND: R8.1, R9.1; also elsewhere on the board
GNDPWR: U6.1 (S), U6.3 (S); also elsewhere on the board
LED_GND: D3.1 (K), D4.1 (K); also elsewhere on the board
unnamed: D3.2 (A), R6.2
unnamed: D4.2 (A), R7.2
unnamed: R4.2, R6.1, R8.2, U6.2 (G)
unnamed: R5.2, R7.1, R9.2, U6.4 (G)

Parts of its further copies:
D7, D8, D11, D12, D15, D16, D19, D20, D23, D24, D27, D28, D31, D32, D35, D36, D39, D40, D43, D44, D47, D48: RED LED; LED_0402_1005Metric; LCSC C397045
D9, D10, D13, D14, D17, D18, D21, D22, D25, D26, D29, D30, D33, D34, D37, D38, D41, D42, D45, D46, D49, D50: SM4007; D_SOD-123; LCSC C64898
R10, R11, R16, R17, R22, R23, R28, R29, R34, R35, R40, R41, R46, R47, R52, R53, R58, R59, R64, R65, R70, R71: 220R; R_0402_1005Metric; LCSC C25091
R12, R13, R18, R19, R24, R25, R30, R31, R36, R37, R42, R43, R48, R49, R54, R55, R60, R61, R66, R67, R72, R73: 5.1k; R_0402_1005Metric; LCSC C25905
R14, R15, R20, R21, R26, R27, R32, R33, R38, R39, R44, R45, R50, R51, R56, R57, R62, R63, R68, R69, R74, R75: 100k; R_0402_1005Metric; LCSC C25741
U7, U8, U9, U10, U11, U12, U13, U14, U15, U16, U17: AO4882; SOIC-8_3.9x4.9mm_P1.27mm; LCSC C477943

Connections of its further copies:
+12V: D9.1 (K), D10.1 (K), D13.1 (K), D14.1 (K), D17.1 (K), D18.1 (K), D21.1 (K), D22.1 (K), D25.1 (K), D26.1 (K), D29.1 (K), D30.1 (K), D33.1 (K), D34.1 (K), D37.1 (K), D38.1 (K), D41.1 (K), D42.1 (K), D45.1 (K), D46.1 (K), D49.1 (K), D50.1 (K); also elsewhere on the board
/MOSFET_DRIVE1/GATE_1: R10.1; also elsewhere on the board
/MOSFET_DRIVE1/GATE_2: R11.1; also elsewhere on the board
/MOSFET_DRIVE2/GATE_1: R16.1; also elsewhere on the board
/MOSFET_DRIVE2/GATE_2: R17.1; also elsewhere on the board
/MOSFET_DRIVE3/GATE_1: R22.1; also elsewhere on the board
/MOSFET_DRIVE3/GATE_2: R23.1; also elsewhere on the board
/MOSFET_DRIVE4/GATE_1: R28.1; also elsewhere on the board
/MOSFET_DRIVE4/GATE_2: R29.1; also elsewhere on the board
/MOSFET_DRIVE5/GATE_1: R34.1; also elsewhere on the board
/MOSFET_DRIVE5/GATE_2: R35.1; also elsewhere on the board
/MOSFET_DRIVE6/GATE_1: R40.1; also elsewhere on the board
/MOSFET_DRIVE6/GATE_2: R41.1; also elsewhere on the board
/MOSFET_DRIVE7/GATE_1: R46.1; also elsewhere on the board
/MOSFET_DRIVE7/GATE_2: R47.1; also elsewhere on the board
/MOSFET_DRIVE8/GATE_1: R52.1; also elsewhere on the board
/MOSFET_DRIVE8/GATE_2: R53.1; also elsewhere on the board
/MOSFET_DRIVE9/GATE_1: R58.1; also elsewhere on the board
/MOSFET_DRIVE9/GATE_2: R59.1; also elsewhere on the board
/MOSFET_DRIVE10/GATE_1: R64.1; also elsewhere on the board
/MOSFET_DRIVE10/GATE_2: R65.1; also elsewhere on the board
/MOSFET_DRIVE11/GATE_1: R70.1; also elsewhere on the board
/MOSFET_DRIVE11/GATE_2: R71.1; also elsewhere on the board
/SOLENOID_3: D9.2 (A), U7.7 (D), U7.8 (D); also elsewhere on the board
/SOLENOID_4: D10.2 (A), U7.5 (D), U7.6 (D); also elsewhere on the board
/SOLENOID_5: D13.2 (A), U8.7 (D), U8.8 (D); also elsewhere on the board
/SOLENOID_6: D14.2 (A), U8.5 (D), U8.6 (D); also elsewhere on the board
/SOLENOID_7: D17.2 (A), U9.7 (D), U9.8 (D); also elsewhere on the board
/SOLENOID_8: D18.2 (A), U9.5 (D), U9.6 (D); also elsewhere on the board
/SOLENOID_9: D21.2 (A), U10.7 (D), U10.8 (D); also elsewhere on the board
/SOLENOID_10: D22.2 (A), U10.5 (D), U10.6 (D); also elsewhere on the board
/SOLENOID_11: D25.2 (A), U11.7 (D), U11.8 (D); also elsewhere on the board
/SOLENOID_12: D26.2 (A), U11.5 (D), U11.6 (D); also elsewhere on the board
/SOLENOID_13: D29.2 (A), U12.7 (D), U12.8 (D); also elsewhere on the board
/SOLENOID_14: D30.2 (A), U12.5 (D), U12.6 (D); also elsewhere on the board
/SOLENOID_15: D33.2 (A), U13.7 (D), U13.8 (D); also elsewhere on the board
/SOLENOID_16: D34.2 (A), U13.5 (D), U13.6 (D); also elsewhere on the board
/SOLENOID_17: D37.2 (A), U14.7 (D), U14.8 (D); also elsewhere on the board
/SOLENOID_18: D38.2 (A), U14.5 (D), U14.6 (D); also elsewhere on the board
/SOLENOID_19: D41.2 (A), U15.7 (D), U15.8 (D); also elsewhere on the board
/SOLENOID_20: D42.2 (A), U15.5 (D), U15.6 (D); also elsewhere on the board
/SOLENOID_21: D45.2 (A), U16.7 (D), U16.8 (D); also elsewhere on the board
/SOLENOID_22: D46.2 (A), U16.5 (D), U16.6 (D); also elsewhere on the board
/SOLENOID_23: D49.2 (A), U17.7 (D), U17.8 (D); also elsewhere on the board
/SOLENOID_24: D50.2 (A), U17.5 (D), U17.6 (D); also elsewhere on the board
GND: R14.1, R15.1, R20.1, R21.1, R26.1, R27.1, R32.1, R33.1, R38.1, R39.1, R44.1, R45.1, R50.1, R51.1, R56.1, R57.1, R62.1, R63.1, R68.1, R69.1, R74.1, R75.1; also elsewhere on the board
GNDPWR: U7.1 (S), U7.3 (S), U8.1 (S), U8.3 (S), U9.1 (S), U9.3 (S), U10.1 (S), U10.3 (S), U11.1 (S), U11.3 (S), U12.1 (S), U12.3 (S), U13.1 (S), U13.3 (S), U14.1 (S), U14.3 (S), U15.1 (S), U15.3 (S), U16.1 (S), U16.3 (S), U17.1 (S), U17.3 (S); also elsewhere on the board
LED_GND: D7.1 (K), D8.1 (K), D11.1 (K), D12.1 (K), D15.1 (K), D16.1 (K), D19.1 (K), D20.1 (K), D23.1 (K), D24.1 (K), D27.1 (K), D28.1 (K), D31.1 (K), D32.1 (K), D35.1 (K), D36.1 (K), D39.1 (K), D40.1 (K), D43.1 (K), D44.1 (K), D47.1 (K), D48.1 (K); also elsewhere on the board
unnamed: D7.2 (A), R12.2
unnamed: D8.2 (A), R13.2
unnamed: D11.2 (A), R18.2
unnamed: D12.2 (A), R19.2
unnamed: D15.2 (A), R24.2
unnamed: D16.2 (A), R25.2
unnamed: D19.2 (A), R30.2
unnamed: D20.2 (A), R31.2
unnamed: D23.2 (A), R36.2
unnamed: D24.2 (A), R37.2
unnamed: D27.2 (A), R42.2
unnamed: D28.2 (A), R43.2
unnamed: D31.2 (A), R48.2
unnamed: D32.2 (A), R49.2
unnamed: D35.2 (A), R54.2
unnamed: D36.2 (A), R55.2
unnamed: D39.2 (A), R60.2
unnamed: D40.2 (A), R61.2
unnamed: D43.2 (A), R66.2
unnamed: D44.2 (A), R67.2
unnamed: D47.2 (A), R72.2
unnamed: D48.2 (A), R73.2
unnamed: R10.2, R12.1, R14.2, U7.2 (G)
unnamed: R11.2, R13.1, R15.2, U7.4 (G)
unnamed: R16.2, R18.1, R20.2, U8.2 (G)
unnamed: R17.2, R19.1, R21.2, U8.4 (G)
unnamed: R22.2, R24.1, R26.2, U9.2 (G)
unnamed: R23.2, R25.1, R27.2, U9.4 (G)
unnamed: R28.2, R30.1, R32.2, U10.2 (G)
unnamed: R29.2, R31.1, R33.2, U10.4 (G)
unnamed: R34.2, R36.1, R38.2, U11.2 (G)
unnamed: R35.2, R37.1, R39.2, U11.4 (G)
unnamed: R40.2, R42.1, R44.2, U12.2 (G)
unnamed: R41.2, R43.1, R45.2, U12.4 (G)
unnamed: R46.2, R48.1, R50.2, U13.2 (G)
unnamed: R47.2, R49.1, R51.2, U13.4 (G)
unnamed: R52.2, R54.1, R56.2, U14.2 (G)
unnamed: R53.2, R55.1, R57.2, U14.4 (G)
unnamed: R58.2, R60.1, R62.2, U15.2 (G)
unnamed: R59.2, R61.1, R63.2, U15.4 (G)
unnamed: R64.2, R66.1, R68.2, U16.2 (G)
unnamed: R65.2, R67.1, R69.2, U16.4 (G)
unnamed: R70.2, R72.1, R74.2, U17.2 (G)
unnamed: R71.2, R73.1, R75.2, U17.4 (G)

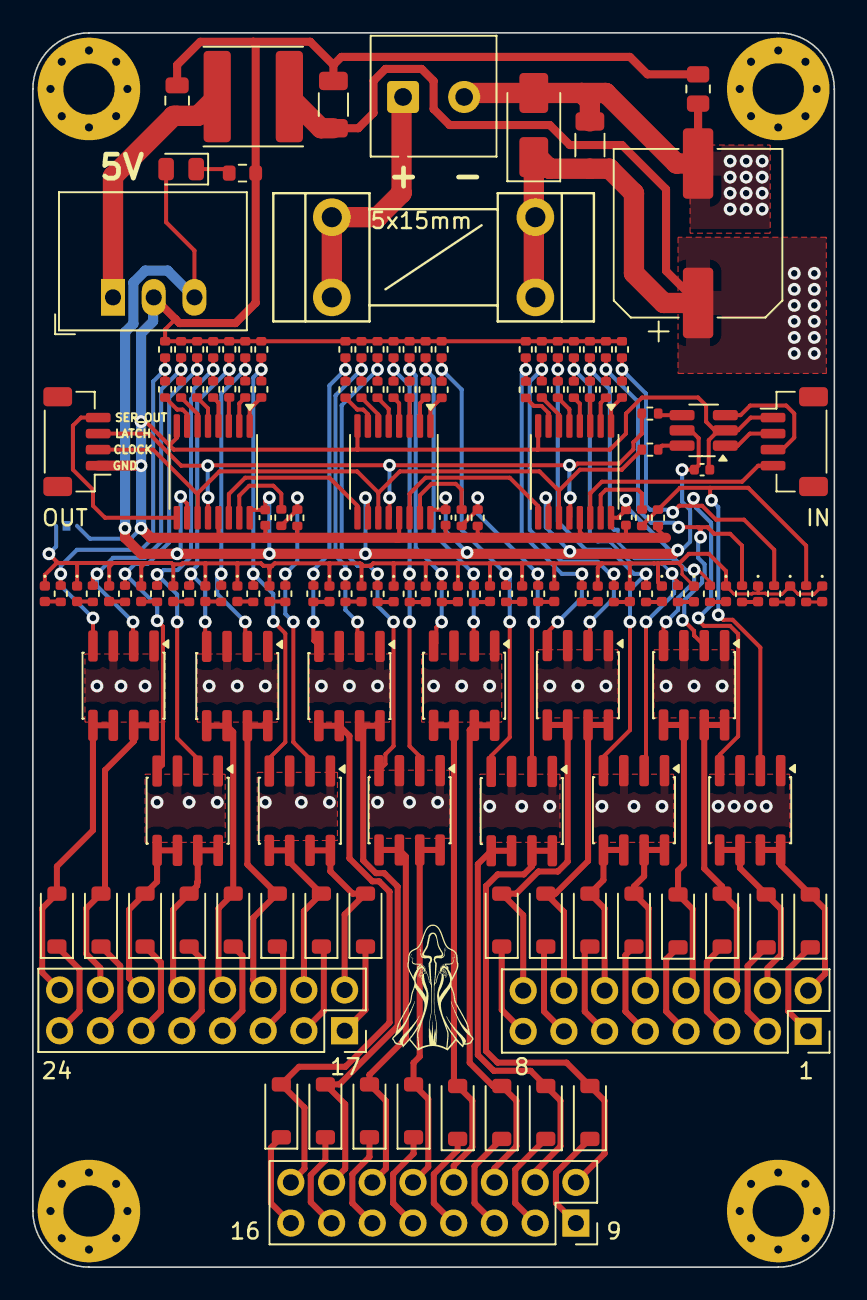
[picture p16: board Jacquard_Machine_Driver.kicad_pcb from above]

Board: 2 copper layers, 50.0 x 77.0 mm, 164 parts (1 on the bottom side), 114 nets.
