dbornhorst/JacquardMachine-PCB/(commit log)

2026-05-06 Driver board done
    [Jacquard_Machine.kicad_pcb, Jacquard_Machine.kicad_sch, Jacquard_Machine_Brain.kicad_pcb, Jacquard_Machine_Brain.kicad_sch, Jacquard_Machine_Driver.kicad_pcb, Jacquard_Machine_Driver.kicad_sch, Jacquard_Machine_Driver.step, mosfet_drive.kicad_sch]
2026-05-26 Further progress on the brain
    [Jacquard_Machine_Brain.kicad_pcb, Jacquard_Machine_Brain.kicad_sch]
2026-09-10 Progress check
    [Jacquard_Machine_Brain.kicad_pcb, Jacquard_Machine_Brain.kicad_sch]
2026-09-16 Connected the UI buttons
    [Jacquard_Machine_Brain.kicad_pcb, Jacquard_Machine_Brain.kicad_sch]
2026-09-17 PCB Wrap up
    [Jacquard_Machine.kicad_pcb, Jacquard_Machine.kicad_sch, Jacquard_Machine_Brain.kicad_pcb, Jacquard_Machine_Brain.kicad_sch, Jacquard_Machine_Driver.kicad_pcb, Jacquard_Machine_Driver.kicad_sch, Jacquard_Machine_Driver.step, bom.csv]
